phuchuynhbk24-cmd/Smart_Room_Control/docs/SYSTEM_SPECIFICATION_REPORT.docx

BÁO CÁO ĐẶC TẢ HỆ THỐNG
(SYSTEM SPECIFICATION REPORT)

DỰ ÁN: HỆ THỐNG ĐIỀU KHIỂN PHÒNG THÔNG MINH (SMART ROOM CONTROL)
PHÂN HỆ: GIAO DIỆN HMI, MÀN HÌNH TFT, CẢM ỨNG, NÚT BẤM VÀ CƠ CẤU CHẤP HÀNH RELAY
Chuẩn cấu trúc 5 giai đoạn tài liệu (Documents for System Specification)

• Phạm vi thực hiện: Phân hệ của Coder 1 (Màn hình màu TFT ILI9341, Cảm ứng điện trở XPT2046, Khối 4 nút cơ SW2..SW5, Khối 4 Rơ-le công suất, Dịch vụ HMI & Input Manager).
• Nền tảng phần cứng: Vi điều khiển STM32F103C8T6 (ARM Cortex-M3 @ 72 MHz, 64 KB Flash, 20 KB SRAM).
• Mô hình tài liệu: Tuân thủ cấu trúc 5 tầng tài liệu (Documents for System Specification):
[1. Product Requirement] -> [2. Design Specification] -> [3. Hardware Specification] -> [4. Software Specification] -> [5. Test Specification]
• Môn học: Thiết kế Hệ thống Nhúng (ESD) - Bộ môn Kỹ thuật Điện tử, Trường ĐH Bách Khoa TP.HCM.

1. PRODUCT REQUIREMENT (ĐẶC TẢ YÊU CẦU SẢN PHẨM)

1.1. Mục đích sản phẩm (Product Purpose):
Phân hệ đảm nhiệm vai trò trung tâm giao tiếp Người - Máy (HMI) và thực thi chấp hành trong hệ thống phòng thông minh. Sản phẩm cung cấp bảng điều khiển trung tâm (Dashboard) hiển thị thông số môi trường trực quan, cho phép người dùng điều khiển 4 thiết bị phụ tải qua cả hai phương thức: Màn hình cảm ứng hiện đại và Nút bấm vật lý truyền thống.

1.2. Yêu cầu chức năng (Functional Requirements):
• FR1 - Giám sát môi trường thời gian thực: Hiển thị liên tục Nhiệt độ (độ C, float), Độ ẩm (%, float), Độ sáng (%, float) và Trạng thái có người PIR (Phát hiện / Yên tĩnh, bool) nhận từ phân hệ cảm biến.
• FR2 - Điều khiển phụ tải 4 kênh: Điều khiển độc lập 4 thiết bị (Quạt làm mát, Đèn chiếu sáng 1, Đèn chiếu sáng 2, Máy hút ẩm) qua các rơ-le công suất cách ly quang.
• FR3 - Chế độ kép AUTO / MANUAL: Cho phép chuyển đổi linh hoạt giữa chế độ tự động (AUTO: tự đóng ngắt phụ tải theo ngưỡng môi trường) và chế độ thủ công (MANUAL: người dùng tự do bật/tắt thiết bị).
• FR4 - Trọng tài ưu tiên phần cứng (Hardware Priority): Khi có thao tác đồng thời giữa nút bấm cơ và màn hình cảm ứng, nút bấm vật lý luôn có quyền quyết định tối cao; màn hình cảm ứng phải bị vô hiệu hóa tạm thời.
• FR5 - Khóa an toàn chế độ tự động (AUTO Lockout): Ở chế độ AUTO, các tác động điều khiển rơ-le thủ công (từ cả nút bấm và cảm ứng) bị từ chối và hiển thị cảnh báo để tránh xung đột với thuật toán tự động.

1.3. Yêu cầu phi chức năng (Non-Functional Requirements):
• NFR1 - Thời gian đáp ứng (Response Time): Độ trễ từ khi nhấn nút cơ hoặc chạm màn hình đến khi rơ-le đổi trạng thái <= 50 ms.
• NFR2 - Hiển thị không nhấp nháy (Zero-Flicker): Tốc độ cập nhật vùng số liệu đồ họa <= 3 ms; không được xóa toàn bộ màn hình khi cập nhật thông số.
• NFR3 - Trải nghiệm thị giác (Ergonomics): Giao diện thiết kế theo phong cách Dark Mode hiện đại, màu sắc tương phản cao (Cam cho Nhiệt độ, Xanh cho Độ ẩm, Vàng cho Độ sáng, Đỏ cho Cảnh báo PIR).
• NFR4 - An toàn điện & Chống sốc (Electrical Isolation): Cách ly quang hoàn toàn giữa khối điều khiển 3.3V và tải công suất 220VAC/12VDC qua Optocoupler; tích hợp diode triệt tiêu xung ngược Back-EMF.

2. DESIGN SPECIFICATION (ĐẶC TẢ THIẾT KẾ HỆ THỐNG & PHÂN RÃ)

2.1. Phân rã kiến trúc phân hệ (Subsystem Functional Decomposition):
Phân hệ của Coder 1 được phân tách thành 5 phân hệ chức năng tương tác đồng bộ:

Phân hệ (Subsystem) | Chức năng chính | Công nghệ / IC sử dụng | Phân bổ HW / SW
Display Subsystem | Hiển thị giao diện đồ họa màu 240x320 | Module LCD 2.8" SPI, IC ILI9341 | HW: Bus SPI1 | SW: Driver ILI9341
Touch Subsystem | Đọc tọa độ chạm, định chuẩn pixel | Cảm ứng điện trở 4 dây, IC XPT2046 | HW: Bus SPI2 | SW: Lọc trung vị 7 mẫu
Physical Button Subsystem | Tiếp nhận 4 phím bấm cơ khí ưu tiên | 4x Tactile Switches, mạch lọc RC | HW: GPIO Pull-up | SW: Debounce 25ms
Actuator Output Subsystem | Kích hoạt đóng ngắt 4 rơ-le công suất | 4x SRD-05VDC, Opto PC817, 1N4148 | HW: GPIO Push-pull | SW: Driver Relay
HMI & Input Arbitration | Quản lý giao diện, giải quyết xung đột | Middleware UI Dashboard & Input Manager | SW: Tầng Middleware thuần C

2.2. Sơ đồ khối kiến trúc hệ thống (System Block Diagram):
Luồng điều khiển và luồng dữ liệu giữa các khối phần cứng và các module phần mềm:

┌────────────────────────────────────────────────────────────────────────┐
│ STM32F103C8T6 (72 MHz) │
│ │
│ [TẦNG APP] app_loop() Executive Loop (Kịch bản AUTO / MANUAL) │
│ ▲ │ │
│ │ Event ▼ Telemetry/Cmd │
│ [TẦNG MIDDLEWARE] │
│ ├── Input Manager (Trọng tài: Nút cơ > Cảm ứng TFT) │
│ └── UI Dashboard Service (Render vùng thẻ, thanh tiến trình) │
│ ▲ │ │
│ │ Status/Coords ▼ Drawing/Pulse │
│ [TẦNG DEVICE] │
│ ├── button_driver ├── xpt2046_driver ├── ili9341_driver │
│ └── relay_driver └── sensor_interface (Coder 2 data) │
└───────┬────────────────────────┬───────────────────────┬───────────────┘
│ GPIO (PA3,PB2,PA10,11) │ SPI2 (2.25 MHz) │ SPI1 (18 MHz)
▼ ▼ ▼
[4x Nút bấm cơ] [IC Touch XPT2046] [TFT LCD ILI9341]
(SW2,SW4,SW3,SW5) (Resistive 4-wire) (2.8 inch 240x320)
│ │
┌────────────────────────┘ │
▼ GPIO (PB4,PA15,PB6,PA12) ▼
[4x Relay Opto-isolated] [Bảng điều khiển HMI]
(FAN, LIGHT1, LIGHT2, DEHUM) (Giao diện Dark Mode)

3. HARDWARE SPECIFICATION (ĐẶC TẢ CHI TIẾT PHẦN CỨNG)

3.1. Đặc tả Lựa chọn Xung nhịp & Bus ngoại vi (Clock Selection & Bus Timing):
• Thạch anh hệ thống: HSE = 8.000 MHz nhân tần PLL x9 -> SYSCLK = HCLK = 72.000 MHz.
• Bus APB2 (PCLK2 = 72 MHz) cấp xung cho SPI1 (Màn hình ILI9341):
- Ràng buộc Datasheet ILI9341: Chu kỳ ghi nối tiếp tối thiểu T_SCYCW = 66 ns (f_max = 15.15 MHz).
- Lựa chọn bộ chia: SPI_BAUDRATEPRESCALER_4 -> f_SCK1 = 72 MHz / 4 = 18.000 MHz (T = 55.5 ns).
- Biện luận: Tần số 18 MHz nằm trong dải dung sai thực tế của silicon ILI9341 ở điện áp 3.3V, tối đa hóa thông lượng dữ liệu (18 Mbps) giúp cập nhật đồ họa mượt mà.
• Bus APB1 (PCLK1 = 36 MHz) cấp xung cho SPI2 (Cảm ứng XPT2046):
- Ràng buộc Datasheet XPT2046: Xung nhịp đồng hồ ADC tối đa cho phép f_DCLK_max = 2.500 MHz.
- Lựa chọn bộ chia: SPI_BAUDRATEPRESCALER_16 -> f_SCK2 = 36 MHz / 16 = 2.250 MHz <= 2.500 MHz.
- Biện luận: Đảm bảo độ chính xác chuyển đổi SAR ADC 12-bit, không làm nóng chip hay trôi giá trị đo.

3.2. Bảng phân bổ chân kết nối phần cứng vi điều khiển (Pinout Assignment):

Tên khối / Ngoại vi | Chân Module | Chân STM32 | Chế độ GPIO HAL | Thông số điện & Tần số
TFT LCD ILI9341 | SCK | PA5 | GPIO_MODE_AF_PP (High) | SPI1 Clock (18.0 MHz, 3.3V Logic)
TFT LCD ILI9341 | MOSI (SDI) | PA7 | GPIO_MODE_AF_PP (High) | SPI1 Master-Out Data (3.3V Logic)
TFT LCD ILI9341 | CS | PB0 | GPIO_MODE_OUTPUT_PP (High) | Tín hiệu chọn chip màn hình (Active-LOW)
TFT LCD ILI9341 | DC (RS) | PB1 | GPIO_MODE_OUTPUT_PP (High) | 0 = Command Byte, 1 = Data Byte
TFT LCD ILI9341 | RST | PA4 | GPIO_MODE_OUTPUT_PP (Low) | Reset phần cứng (Xung thấp >= 10 us)
TFT LCD ILI9341 | LED (BL) | +3.3V | Nối nguồn qua trở hạn dòng | Đèn nền LED Backlight (Dòng 60-80 mA)
Touch XPT2046 | T_CLK | PB13 | GPIO_MODE_AF_PP (High) | SPI2 Clock (2.25 MHz, 3.3V Logic)
Touch XPT2046 | T_DO (MISO) | PB14 | GPIO_MODE_INPUT (Floating) | SPI2 Master-In nhận dữ liệu ADC 12-bit
Touch XPT2046 | T_DIN (MOSI) | PB15 | GPIO_MODE_AF_PP (High) | SPI2 Master-Out gửi byte chọn kênh
Touch XPT2046 | T_CS | PB12 | GPIO_MODE_OUTPUT_PP (High) | Tín hiệu chọn chip cảm ứng (Active-LOW)
Touch XPT2046 | T_IRQ | PA8 | GPIO_MODE_INPUT (Pull-Up) | Ngắt báo chạm PENIRQ (Active-LOW)
Nút bấm SW2 (MODE) | PIN_SW2 | PA3 | GPIO_MODE_INPUT (Pull-Up) | Active-LOW, RC chống rung: 10k / 100nF
Nút bấm SW4 (FAN) | PIN_SW4 | PB2 | GPIO_MODE_INPUT (Pull-Up) | Active-LOW, RC chống rung: 10k / 100nF
Nút bấm SW3 (LIGHT1) | PIN_SW3 | PA10 | GPIO_MODE_INPUT (Pull-Up) | Active-LOW, RC chống rung: 10k / 100nF
Nút bấm SW5 (DEHUM) | PIN_SW5 | PA11 | GPIO_MODE_INPUT (Pull-Up) | Active-LOW, RC chống rung: 10k / 100nF
Relay 1 (FAN) | IN_RELAY1 | PB4 | GPIO_MODE_OUTPUT_PP (Low) | Kích Opto PC817 (Active-HIGH, 3.5 mA)
Relay 2 (LIGHT1) | IN_RELAY2 | PA15 | GPIO_MODE_OUTPUT_PP (Low) | Kích Opto PC817 (Active-HIGH, 3.5 mA)
Relay 3 (LIGHT2) | IN_RELAY3 | PB6 | GPIO_MODE_OUTPUT_PP (Low) | Kích Opto PC817 (Active-HIGH, 3.5 mA)
Relay 4 (DEHUM) | IN_RELAY4 | PA12 | GPIO_MODE_OUTPUT_PP (Low) | Kích Opto PC817 (Active-HIGH, 3.5 mA)

3.3. Mạch nguyên lý kết nối & Chống nhiễu phần cứng (Interface Circuits):
• Mạch lọc RC nút bấm: Cấu hình Active-LOW kéo lên 3.3V qua trở R = 10 kOhm và tụ lọc C = 100 nF mắc song song xuống GND. Hằng số thời gian phóng nạp tau = R x C = 1 ms dập tắt các xung dội cơ học ban đầu.
• Mạch cách ly rơ-le: Các chân ngõ ra kích transistor phát quang của Opto PC817 (qua trở hạn dòng 1 kOhm). Phía thứ cấp dẫn dòng kích mở transistor NPN đóng rơ-le 5V. Mắc song song ngược với cuộn hút rơ-le là Diode 1N4148 (Flyback Diode) triệt tiêu sức điện động cảm ứng Back-EMF khi ngắt dòng, bảo vệ tuyệt đối vi điều khiển.

4. SOFTWARE SPECIFICATION (ĐẶC TẢ THIẾT KẾ PHẦN MỀM & FIRMWARE)

4.1. Cấu trúc Firmware 4 tầng (4-Layer Firmware Architecture):
Hệ thống phân tách rạch ròi theo nguyên tắc Inversion of Control:
- Tầng APP (app/app.c, app/app.h): Điều phối chính, quản lý biến trạng thái (s_temp, s_humi, s_light, s_pir, s_mode), định kỳ 1000ms gọi sensor_update() để lấy dữ liệu từ Coder 2 và đánh giá luật kích rơ-le tự động.
- Tầng MIDDLEWARE:
+ input_mgr: Dịch vụ quét đầu vào, áp dụng thuật toán trọng tài ưu tiên (Phím cơ > Cảm ứng TFT).
+ ui_dashboard: Dịch vụ render giao diện đồ họa, vẽ thẻ card số liệu, thanh tiến trình phần trăm.
- Tầng DEVICE (device/): Trình điều khiển trực tiếp phần cứng (ili9341, xpt2046, button, relay, sensor stub).
- Tầng HAL & DRIVERS: Thư viện chuẩn ST HAL (HAL_SPI, HAL_GPIO, HAL_GetTick).

4.2. Đặc tả Thuật toán & Băng thông hiển thị ILI9341:
• Kích thước khung hình đầy đủ: 240 x 320 x 2 bytes = 153.600 bytes (1.228.800 bits).
• Thời gian nạp toàn màn hình ở 18 MHz: T_full = 1.228.800 / (18 x 10^6) = 68.27 ms (~14.64 FPS).
• Thuật toán Vẽ vùng quan tâm (ROI Partial Draw): Chỉ cập nhật vùng ô số liệu thay đổi (kích thước 94 x 28 pixels = 5.264 bytes). Thời gian nạp: T_ROI = 5.264 x 8 / (18 x 10^6) = 2.34 ms (> 420 Hz). Đảm bảo giao diện phản hồi tức thì, hoàn toàn không chớp nháy (Zero-Flicker).
• Kích thước Burst Buffer: 512 bytes (256 pixels). Chiếm 2.5% của 20 KB SRAM, tối ưu hóa hàng đợi FIFO phần cứng của SPI1 mà không gây nguy cơ tràn ngăn xếp (Stack Overflow).
• Chuỗi thanh ghi khởi tạo: Reset cứng -> Software Reset (0x01, chờ >= 120ms) -> Power Control (0xCB, 0xCF, 0xC0, 0xC1, 0xC5, 0xC7) -> Memory Access Control MADCTL (0x36 = 0x08, Portrait BGR) -> Pixel Format (0x3A = 0x55, RGB565 16-bit) -> Sleep Out (0x11, chờ >= 120ms) -> Display ON (0x29).

4.3. Đặc tả Thuật toán Cảm ứng XPT2046:
• Tần số lấy mẫu: 50 Hz (Chu kỳ 20 ms).
• Thuật toán Lọc trung vị 7 mẫu (Median Filter): Thực hiện 7 lần chuyển đổi ADC vi sai (lệnh 0xD0 cho trục X, 0x90 cho trục Y). Sắp xếp mảng tăng dần và lấy mẫu trung vị S[3], loại bỏ triệt để các xung gai điện áp ngẫu nhiên.
• Công thức định chuẩn điểm ảnh (Pixel Calibration):
X_pixel = ((X_raw - 200) * 240) / (3800 - 200)
Y_pixel = 320 - (((Y_raw - 200) * 320) / (3800 - 200))
• Khóa chống dội cảm ứng: Thời gian khóa trễ 180 ms giữa 2 lần chạm liên tiếp.

4.4. Đặc tả Thuật toán Trọng tài Ưu tiên Đầu vào (Input Priority Arbitration):
• Nguyên tắc: Nút bấm vật lý (Hardware Buttons) có độ ưu tiên cao nhất, vượt quyền hoàn toàn màn hình cảm ứng.
• Thực thi: Trong hàm input_mgr_poll(), nếu bất kỳ nút cơ nào đang được đè giữ (button_is_down == true) hoặc vừa có sự kiện nút cơ trong 400 ms trước, mọi tín hiệu chạm màn hình cảm ứng đều bị hủy bỏ (Action = INPUT_ACT_NONE). Màn hình xuất thông báo cảnh báo [HW PRIORITY] BTN OVERRIDE TOUCH.
• Khóa AUTO Mode (AUTO Lockout): Khi s_mode == 1, mọi lệnh điều khiển rơ-le thủ công (từ cả nút cơ và cảm ứng) bị từ chối thực hiện và hiển thị cảnh báo [AUTO-LOCK] màu vàng trên thanh Banner.

5. TEST SPECIFICATION (ĐẶC TẢ KIỂM THỬ HỆ THỐNG)

Tập hợp các ca kiểm thử (Test Cases) nhằm thẩm định và nghiệm thu toàn diện các chỉ tiêu kỹ thuật đã cam kết trong Product Requirement, Hardware Spec và Software Spec:

Mã kiểm thử (Test ID) | Mục tiêu kiểm thử | Quy trình thực hiện & Thiết bị đo | Kết quả mong đợi (Pass Criteria)
TC01 | Kiểm tra Tần số xung nhịp SPI1 và Băng thông màn hình ILI9341 | Kẹp đầu dò máy hiện sóng (Oscilloscope) vào chân PA5 (SCK) và PA7 (MOSI). Cho hệ thống chạy vòng lặp cập nhật số liệu liên tục. | Tần số đo được trên PA5 đạt chính xác 18.0 MHz +/- 0.5%. Dạng sóng vuông rõ ràng. Thời gian cập nhật ô số liệu <= 3 ms. Màn hình không nhấp nháy.
TC02 | Kiểm tra Tần số SPI2 và Độ chính xác cảm ứng XPT2046 | Kẹp que đo vào chân PB13 (SPI2_SCK). Dùng bút cảm ứng chạm lần lượt vào 4 góc màn hình (10,10), (230,10), (10,310), (230,310) và tâm (120,160). | Tần số SCK2 đo được là 2.25 MHz (không vượt 2.5 MHz). Tọa độ pixel hiển thị trên banner chẩn đoán sai lệch so với vị trí chạm thực tế <= 3 pixels.
TC03 | Kiểm tra Bộ lọc Chống rung 2 tầng của Nút bấm cơ khí | Kẹp kênh 1 Oscilloscope vào chân nút bấm (PA3) trước mạch RC, kênh 2 vào sau mạch RC. Nhấn nhả liên tục 50 lần với tốc độ nhanh. | Xung dội cơ học bị mạch RC san phẳng đáng kể. Phần mềm (Debounce 25ms) chỉ ghi nhận đúng 1 xung trigger (was_pressed) trên mỗi lần nhấn. Không bị kích đúp.
TC04 | Kiểm nghiệm Luật Trọng tài Ưu tiên (Hardware Button vs. Touch) | Dùng một ngón tay ấn giữ nút cơ SW4 (Bật Quạt), đồng thời tay kia chạm liên tục vào nút ảo trên màn hình cảm ứng để bật đèn hoặc đổi chế độ. | Màn hình cảm ứng bị vô hiệu hóa hoàn toàn, không có lệnh rơ-le nào từ cảm ứng được thực thi. Thanh Banner hiển thị dòng chữ [HW PRIORITY] BTN OVERRIDE TOUCH.
TC05 | Kiểm tra Thời gian đáp ứng Đóng/Ngắt Rơ-le và Xung ngược | Kẹp que đo kênh 1 vào chân kích GPIO (PB4), kênh 2 vào tiếp điểm ra của rơ-le. Kích hoạt đóng/ngắt liên tục. | Thời gian trễ từ khi chân PB4 lên mức 1 đến khi tiếp điểm rơ-le đóng lại <= 10 ms. Diode 1N4148 dập tắt hoàn toàn xung nhọn quá áp (Back-EMF <= 0.7V).
TC06 | Kiểm tra Khóa chế độ AUTO (AUTO Mode Lockout Enforcement) | Chuyển hệ thống sang chế độ AUTO (s_mode = 1, badge hiển thị AUTO màu xanh). Dùng nút cơ hoặc cảm ứng để cố gắng bật/tắt rơ-le. | Trạng thái 4 rơ-le hoàn toàn không thay đổi (duy trì theo ngưỡng cảm biến). Màn hình hiển thị nhãn cảnh báo [AUTO-LOCK] màu vàng trên nền đỏ đậm.
TC07 | Kiểm nghiệm Ổn định Dài hạn (Reliability & Memory Leak Test) | Cho hệ thống chạy liên tục 24 giờ trong điều kiện nhiệt độ phòng. Giả lập tín hiệu cảm biến biến động liên tục. | Hệ thống không bị treo (Watchdog/HardFault), không tràn bộ nhớ (RAM giữ nguyên 3.01 KB), không rớt khung hình hiển thị.

Trường ĐH Bách Khoa TP.HCM - Bộ môn Kỹ thuật Điện tử | System Specification Document

Smart Room Control | System Specification Report
