phuchuynhbk24-cmd/Smart_Room_Control/docs/SPEC_FIRMWARE_TFT.docx

ĐẶC TẢ KỸ THUẬT FIRMWARE
(FIRMWARE SPECIFICATION)

TRÌNH ĐIỀU KHIỂN & GIAO DIỆN MÀN HÌNH MÀU TFT LCD (ILI9341 + XPT2046)
Dự án: Hệ Thống Điều Khiển Phòng Thông Minh (Smart Room Control)

• Mục tiêu thiết kế: Xây dựng bộ thư viện điều khiển đồ họa hiệu năng cao, không giật hình (Zero-Flicker), xử lý cảm ứng chống nhiễu và trọng tài đầu vào ưu tiên phần cứng.
• Nền tảng thực thi: STM32F103C8T6 (Core ARM Cortex-M3 @ 72 MHz, 64 KB Flash, 20 KB SRAM)
• Môi trường phát triển: STM32CubeIDE / GNU Toolchain for STM32 (GCC 14.3.rel1)
• Tiêu chuẩn kiến trúc: Kiến trúc phân tầng độc lập (Decoupled Layered Architecture: App -> Middleware -> Device -> HAL)

1. KIẾN TRÚC PHÂN TẦNG FIRMWARE (DECOUPLED 4-LAYER ARCHITECTURE)

Toàn bộ mã nguồn firmware của dự án được tổ chức chặt chẽ theo 4 tầng tách biệt, bảo đảm khả năng mở rộng, dễ bảo trì và phân công công việc đa thành viên (Multi-developer collaboration):

• Tầng 1 - Application Layer (app/): Chứa logic nghiệp vụ tối cao, vòng lặp executive loop không khóa (non-blocking), kiểm tra ngưỡng môi trường để kích hoạt rơ-le tự động trong chế độ AUTO. Tầng App không được phép gọi trực tiếp các hàm HAL.
• Tầng 2 - Middleware Layer (middleware/): Bao gồm Dịch vụ Giao diện Đồ họa (ui_dashboard) xây dựng thẻ card, thanh đo tiến trình, và Dịch vụ Quản lý Đầu vào (input_mgr) thực hiện trọng tài ưu tiên giữa phím bấm vật lý và màn hình cảm ứng.
• Tầng 3 - Device Layer (device/): Các driver thiết bị ngoại vi độc lập: ili9341 (màn hình LCD), xpt2046 (bộ điều khiển cảm ứng), button (nút bấm chống rung), relay (đóng ngắt phụ tải) và sensor (giao diện kéo dữ liệu từ Coder 2).
• Tầng 4 - Drivers / HAL & Core Layer (Core/, Drivers/): Mã khởi tạo thạch anh, GPIO, bus SPI và thư viện phần cứng STM32F1xx HAL Driver.

2. CẤU HÌNH THAM SỐ NGOẠI VI STM32 HAL (PERIPHERAL CONFIGURATION)

Chi tiết các tham số nạp vào cấu trúc khởi tạo phần cứng trong mã nguồn C:

Thông số cấu hình | Bộ ngoại vi SPI1 (Màn hình ILI9341) | Bộ ngoại vi SPI2 (Cảm ứng XPT2046) | Căn cứ kỹ thuật lựa chọn
Bus nguồn cấp Clock | APB2 Bus (f_PCLK2 = 72 MHz) | APB1 Bus (f_PCLK1 = 36 MHz) | Giới hạn tối đa của bus vi điều khiển
BaudRate Prescaler | SPI_BAUDRATEPRESCALER_4 | SPI_BAUDRATEPRESCALER_16 | Bộ chia xung nhịp từ bus ngoại vi
Tần số xung nhịp SCK | 18.000 MHz (Chu kỳ 55.5 ns) | 2.250 MHz (Chu kỳ 444.4 ns) | Tiệm cận thông số ILI9341, dưới 2.5 MHz XPT2046
Chế độ SPI (SPI Mode) | Mode 0 (CPOL = 0, CPHA = 0) | Mode 0 (CPOL = 0, CPHA = 0) | Chốt dữ liệu ở sườn lên (Rising Edge)
Độ rộng khung dữ liệu | 8-bit (SPI_DATASIZE_8BIT) | 8-bit (SPI_DATASIZE_8BIT) | Phù hợp gửi lệnh và tách byte pixel RGB565
Thứ tự truyền bit | MSB First (SPI_FIRSTBIT_MSB) | MSB First (SPI_FIRSTBIT_MSB) | Quy chuẩn chip Ilitek & XPTEK
Quản lý Chip Select | Software (SPI_NSS_SOFT) | Software (SPI_NSS_SOFT) | Tự điều khiển chân CS qua GPIO Output
Chế độ hướng dữ liệu | Full-Duplex 2 Lines | Full-Duplex 2 Lines | Truyền nhận đồng thời trên đường MOSI/MISO

3. ĐẶC TẢ CHUỖI LỆNH KHỞI TẠO MÀN HÌNH ILI9341 (INIT COMMANDS & TIMING)

Chuỗi lệnh khởi tạo trong hàm ili9341_init() được lập trình chính xác theo khuyến nghị của Ilitek Application Notes nhằm thiết lập trạng thái nguồn ổn định, nạp đường cong Gamma tối ưu độ tương phản và mở cổng truyền dữ liệu màu:

Mã lệnh (HEX) | Tên thanh ghi chức năng | Dữ liệu nạp (Parameters) | Ý nghĩa kỹ thuật & Ràng buộc thời gian
0x01 | Software Reset (SWRESET) | Không tham số (Chờ >= 120 ms) | Khởi động lại toàn bộ logic nội, xóa cờ Sleep.
0xCB | Power Control A (PWCTRA) | 0x39, 0x2C, 0x00, 0x34, 0x02 | Cấu hình dòng xả Vcore và bảo vệ tụ bơm áp.
0xCF | Power Control B (PWCTRB) | 0x00, 0xC1, 0x30 | Kích hoạt mạch chống ESD xung điện áp ban đầu.
0xE8 | Driver Timing Control A | 0x85, 0x00, 0x78 | Định thì thời gian chuyển mạch cổng Gate non-overlap.
0xEA | Driver Timing Control B | 0x00, 0x00 | Định thì cân bằng tải cho các đường Source driver.
0xED | Power On Sequence Control | 0x64, 0x03, 0x12, 0x81 | Kiểm soát thứ tự nâng áp VGH/VGL chống vệt đen LCD.
0xF7 | Pump Ratio Control | 0x20 | Cài đặt tỉ lệ bơm áp nội x2 cho mạch tạo áp cao.
0xC0 | Power Control 1 (PWCTR1) | 0x23 | Thiết lập mức điện áp GVDD = 4.60 V.
0xC1 | Power Control 2 (PWCTR2) | 0x10 | Hệ số nhân điện áp cuộn lái dòng bước AVP/AVN.
0xC5 | VCOM Control 1 (VMCTR1) | 0x3E, 0x28 | VCOMH = 4.250 V, VCOML = -1.500 V cân bằng điện tích.
0xC7 | VCOM Control 2 (VMCTR2) | 0x86 | Offset VCOM triệt tiêu hoàn toàn hiện tượng rung hình (flicker).
0x36 | Memory Access Control (MADCTL) | 0x08 | Quét hướng dọc (Portrait), thứ tự lọc màu BGR.
0x3A | Pixel Format Set (COLMOD) | 0x55 | Thiết lập chuẩn màu 16-bit/pixel (RGB565, 65K màu).
0xB1 | Frame Rate Control (FRMCTR1) | 0x00, 0x18 | Tần số quét màng LCD nội bộ đạt 79 Hz (Chống nháy mắt).
0xE0 | Positive Gamma Correction | 15 Bytes thông số Gamma | Nạp đường cong Gamma dương (Tăng độ nét màu sáng).
0xE1 | Negative Gamma Correction | 15 Bytes thông số Gamma | Nạp đường cong Gamma âm (Tăng độ sâu màu tối).
0x11 | Sleep Out (SLPOUT) | Không tham số (Chờ >= 120 ms) | Mở mạch tạo dao động nội, nạp đầy điện tích màng LCD.
0x29 | Display ON (DISPON) | Không tham số | Kích hoạt xuất tín hiệu hình ảnh ra panel LCD.

4. TÍNH TOÁN BĂNG THÔNG, TỐC ĐỘ LÀM TƯƠI & BỘ ĐỆM BURST BUFFER

4.1. Băng thông truyền dữ liệu toàn khung hình (Full Frame Transfer):
- Số điểm ảnh trên màn hình: 240 x 320 = 76.800 pixels.
- Dung lượng dữ liệu 1 khung hình 16-bit màu: 76.800 x 2 bytes = 153.600 bytes = 1.228.800 bits.
- Thời gian truyền lý thuyết ở tốc độ bus SPI 18.0 MHz (18 Mbps):
T_frame = 1.228.800 bits / (18 x 10^6 bps) = 68.27 ms.
- Tốc độ quét khung hình tối đa khi xóa toàn màn hình: FPS_max = 1 / 0.06827 s = 14.64 khung hình/giây.
Nhận xét: Nếu mỗi chu kỳ cập nhật dữ liệu cảm biến đều xóa và vẽ lại toàn bộ 153.6 KB, vi điều khiển sẽ bị chiếm dụng bus SPI liên tục gần 70 ms, gây ra hiện tượng giật màn hình rõ rệt bằng mắt thường.

4.2. Chiến lược Vẽ một phần theo vùng quan tâm (ROI - Region of Interest Partial Refresh):
Firmware áp dụng phương pháp vẽ khung tĩnh một lần duy nhất lúc khởi động (UI_Init_Dashboard). Khi có dữ liệu cảm biến mới hoặc trạng thái rơ-le thay đổi:
- Chỉ mở cửa sổ địa chỉ RAM nội (Window Set: 0x2A, 0x2B, 0x2C) đúng kích thước ô số liệu (ví dụ ô nhiệt độ: 94 x 28 pixels = 2.632 pixels = 5.264 bytes).
- Thời gian truyền dữ liệu vùng số liệu:
T_ROI = (5.264 bytes x 8) / (18 x 10^6 bps) = 2.34 ms.
- Tốc độ làm tươi cục bộ: Tương đương > 420 Hz. Số liệu được cập nhật tức thì, mượt mà và triệt tiêu 100% hiện tượng chớp nháy (Zero-Flicker).

4.3. Đặc tả Bộ đệm truyền khối (Burst Buffer Specification):
Trong file device/ili9341/ili9341.c, bộ đệm truyền khối được ấn định kích thước:
#define BURST_PIXEL_CHUNK 256
static uint8_t s_burst_buffer[BURST_PIXEL_CHUNK * 2]; // 512 Bytes
Cơ sở kỹ thuật lựa chọn 512 Bytes:
• Vi điều khiển STM32F103C8T6 có tổng cộng 20 KB SRAM. Một mảng 512 bytes chỉ chiếm đúng 2.5% tổng dung lượng SRAM, đảm bảo an toàn tuyệt đối cho ngăn xếp (Stack) và các biến toàn cục khác.
• Khối 512 bytes đủ lớn để tận dụng tối đa hàng đợi phần cứng (FIFO) của bộ truyền SPI, giảm thiểu chi phí chuyển ngữ cảnh (Function Call Overhead) so với việc gửi từng pixel đơn lẻ.

5. ĐẶC TẢ GIẢI THUẬT CẢM ỨNG XPT2046 (FILTERING & CALIBRATION)

5.1. Tần số lấy mẫu và Giao thức đọc ADC:
- Tần số kiểm tra chạm cảm ứng: 50 Hz (Chu kỳ quét định kỳ 20 ms trong app_loop).
- Chân ngắt chạm phần cứng T_IRQ (PA8) được kéo lên mức 1. Khi có lực nhấn làm hai lớp màng điện trở chạm nhau, chân IRQ bị kéo xuống mức 0, kích hoạt hàm đọc tọa độ.
- Byte lệnh chọn kênh ADC gửi qua SPI2: 0xD0 (Đọc tọa độ trục X) và 0x90 (Đọc tọa độ trục Y) ở chế độ 12-bit phân giải vi sai.

5.2. Thuật toán Lọc trung vị 7 mẫu (Median Filter 7 Samples):
Do đặc tính vật lý của cảm ứng điện trở dễ bị ảnh hưởng bởi nhiễu nguồn và lực tì tay không đồng đều, driver không lấy kết quả của một mẫu đơn lẻ mà thực hiện quy trình lọc 7 mẫu liên tiếp:
1. Thực hiện 7 lần đọc ADC liên tiếp trên cùng một trục tọa độ: S = [s0, s1, s2, s3, s4, s5, s6].
2. Áp dụng thuật toán sắp xếp nổi bọt (Bubble Sort) để xếp dãy mẫu theo thứ tự tăng dần: S_sorted = sort(S).
3. Chọn mẫu nằm chính giữa S_sorted[3] làm giá trị đại diện.
Hiệu quả: Loại bỏ triệt để các xung gai điện áp đột biến (spikes) ở hai đầu biên, giá trị tọa độ trả về cực kỳ ổn định, không bị hiện tượng con trỏ nhảy nhót.

5.3. Công thức Hiệu chuẩn và Ánh xạ Tọa độ sang Điểm ảnh (Coordinate Calibration):
Dải giá trị thực nghiệm từ ADC 12-bit là [X_min, X_max] = [200, 3800] và [Y_min, Y_max] = [200, 3800]. Công thức chuyển đổi sang hệ tọa độ màn hình 240 x 320 pixels:
X_pixel = ((X_raw - 200) * 240) / (3800 - 200)
Y_pixel = 320 - (((Y_raw - 200) * 320) / (3800 - 200))
Giá trị tính toán được kẹp (clamp) chặt trong dải [0, 239] và [0, 319] để chống tràn bộ nhớ.

5.4. Thời gian trễ khóa chống dội cảm ứng (Touch Debounce):
Sau khi ghi nhận một sự kiện chạm hợp lệ (ví dụ chạm nút đổi chế độ hoặc bật quạt), biến đếm thời gian s_last_touch_tick khóa tiếp nhận chạm mới trong vòng 180 ms. Việc này ngăn chặn hiện tượng người dùng nhấn 1 lần nhưng hệ thống nhận thành 2 hoặc 3 lần nhấp chuột liên tiếp.

6. THIẾT KẾ GIAO DIỆN HMI & DỊCH VỤ TRỌNG TÀI ĐẦU VÀO (INPUT ARBITRATION)

6.1. Bảng màu giao diện chuẩn Dark Mode (Định dạng RGB565 16-bit):
Giao diện Dashboard được thiết kế theo phong cách hiện đại với nền tối nhằm tiết kiệm năng lượng và tăng độ tương phản khi nhìn ngoài trời:

Thành phần UI | Mã HEX 16-bit | Mã RGB 24-bit | Ý nghĩa thị giác & Công năng
Màu nền chính (Background) | 0x0821 | #080408 | Màu đen xám sâu, làm nổi bật các thẻ dữ liệu
Màu nền thẻ (Card BG) | 0x2124 | #212421 | Màu xám đậm định hình khối cảm biến
Thanh tiêu đề (Header Bar) | 0x18E3 | #181C18 | Thanh tiêu đề cố định trên cùng màn hình
Nhãn Nhiệt độ (Temp Color) | 0xFA40 | #F84800 | Màu cam đỏ biểu thị thông số nhiệt độ
Nhãn Độ ẩm (Humi Color) | 0x067F | #00CEF8 | Màu xanh ngọc biểu thị thông số độ ẩm
Nhãn Độ sáng (Light Color) | 0xFFE0 | #FFFF00 | Màu vàng tươi biểu thị độ sáng môi trường
Badge Có người (PIR Detected) | 0xF800 | #F80000 | Màu đỏ cảnh báo khi phát hiện chuyển động
Badge Yên tĩnh (PIR Clear) | 0x2945 | #292829 | Màu xám lục biểu thị phòng không có người
Nút trạng thái AUTO | 0x001F | #0000F8 | Màu xanh dương đậm báo hiệu chế độ tự động
Nút trạng thái MANUAL | 0x6320 | #636400 | Màu vàng nâu báo hiệu chế độ thủ công

6.2. Thuật toán Trọng tài Ưu tiên Đầu vào (Input Priority Arbitration):
Được hiện thực hóa trong hàm input_mgr_poll() tại tầng Middleware:
- Nguyên tắc tối cao: Nút bấm vật lý (Hardware Buttons) có độ ưu tiên tuyệt đối so với màn hình cảm ứng TFT.
- Quy tắc xử lý: Khi phát hiện bất kỳ nút bấm cơ nào đang được đè xuống (button_is_down == true) hoặc vừa có sự kiện nút bấm diễn ra trong vòng 400 ms gần nhất, mọi thao tác chạm trên màn hình cảm ứng đều bị vô hiệu hóa hoàn toàn (Action = INPUT_ACT_NONE). Màn hình lập tức hiển thị cảnh báo [HW PRIORITY] BTN OVERRIDE TOUCH trên thanh Banner chẩn đoán.
- Cơ chế khóa chế độ AUTO (AUTO Mode Lockout): Khi hệ thống đang ở chế độ AUTO (s_mode == 1), các lệnh điều khiển rơ-le thủ công từ cả nút bấm cơ và màn hình cảm ứng đều bị từ chối thực thi. Hệ thống giữ nguyên trạng thái đóng ngắt tự động theo cảm biến và phát thông báo [AUTO-LOCK] màu vàng cảnh báo người dùng.

7. DỰ TOÁN TÀI NGUYÊN BỘ NHỚ & TẢI CPU (MEMORY FOOTPRINT & CPU LOAD)

Kết quả đo kiểm thực tế từ bản dịch GCC 14.3 (Optimization -O0 Debug & -Os Release) trên vi điều khiển STM32F103C8T6:

Phân hệ phần mềm | Vị trí thư mục | Dung lượng RAM chiếm dụng | Dung lượng Flash chiếm dụng | Tải CPU ước tính
Driver màn hình LCD | device/ili9341/ | 576 Bytes (gồm 512B Burst Buffer) | 4.05 KB | < 3% (Khi vẽ vùng)
Driver cảm ứng điện trở | device/xpt2046/ | 32 Bytes (Mảng lọc trung vị) | 1.48 KB | < 1% (Quét 50 Hz)
Driver nút bấm chống rung | device/button/ | 48 Bytes (Trạng thái 4 nút) | 0.98 KB | < 0.5% (Quét định kỳ)
Driver điều khiển rơ-le | device/relay/ | 16 Bytes (Trạng thái logic 4 rơ-le) | 0.52 KB | < 0.1% (Khi kích hoạt)
Dịch vụ HMI & Input Manager | middleware/ | 2.34 KB (Font ASCII, chuỗi buffer) | 14.15 KB | < 4% (Format chuỗi)
TỔNG CỘNG PHÂN HỆ HMI | app/ + middleware/ + device/ | 3.01 KB (15.0% của 20 KB SRAM) | 21.18 KB (33.1% của 64 KB Flash) | < 8% CPU trung bình

Trường ĐH Bách Khoa TP.HCM - Bộ môn Kỹ thuật Điện tử | Embedded System Design Specification

Smart Room Control | Firmware Specification
