phuchuynhbk24-cmd/Smart_Room_Control/docs/SPEC_HARDWARE_TFT.docx

ĐẶC TẢ KỸ THUẬT PHẦN CỨNG
(HARDWARE SPECIFICATION)

PHÂN HỆ MÀN HÌNH MÀU TFT LCD (ILI9341 & XPT2046) VÀ NGOẠI VI GIAO TIẾP
Dự án: Hệ Thống Điều Khiển Phòng Thông Minh (Smart Room Control)

• Đối tượng thiết kế: Màn hình màu TFT 2.8" SPI (ILI9341), Cảm ứng điện trở (XPT2046), Khối phím bấm vật lý, Khối rơ-le công suất
• Vi điều khiển trung tâm: STM32F103C8T6 (ARM Cortex-M3 @ 72 MHz, 64 KB Flash, 20 KB SRAM)
• Tài liệu tham chiếu: Datasheet ILI9341 (Ilitek), Datasheet XPT2046 (XPTEK), STM32F103x8 Datasheet & Reference Manual (STMicroelectronics)
• Môn học: Thiết kế Hệ thống Nhúng (ESD) - Bộ môn Kỹ thuật Điện tử, Trường ĐH Bách Khoa TP.HCM

1. TỔNG QUAN VÀ LỰA CHỌN PHẦN CỨNG (HARDWARE OVERVIEW)

Phân hệ phần cứng hiển thị và tương tác người - máy (HMI) của dự án Smart Room Control bao gồm module màn hình TFT màu tích hợp cảm ứng điện trở 4 dây, khối 4 nút nhấn vật lý chống rung và khối 4 kênh rơ-le công suất cách ly quang. Toàn bộ các khối này được kết nối trực tiếp đến vi điều khiển STM32F103C8T6.

1.1. Module Màn hình màu LCD TFT (Model TJCTM24028-SPI):
- IC điều khiển hiển thị: ILI9341 (a-Si TFT LCD Single Chip Driver).
- Kích thước hiển thị: 2.8 inch, vùng hoạt động 43.20 x 57.60 mm.
- Độ phân giải: 240 x 320 điểm ảnh (pixels), hướng hiển thị Portrait (dọc).
- Khả năng hiển thị màu: 16-bit RGB565 (65.536 màu sắc).
- Giao thức truyền thông: 4-line Serial Peripheral Interface (SPI).

1.2. Module Điều khiển Cảm ứng Điện trở (Touch Controller):
- IC giải mã cảm ứng: XPT2046 (tương thích hoàn toàn ADS7843 / HR2046).
- Bộ chuyển đổi tương tự - số: 12-bit SAR ADC, chuyển đổi vi sai hoặc đơn cực.
- Tín hiệu báo chạm phần cứng: Chân PENIRQ (Active-LOW) phát hiện áp lực ngón tay.

1.3. Khối Nút bấm Vật lý và Khối Chấp hành Rơ-le:
- 4 nút bấm cơ khí hành trình ngắn (SW2, SW4, SW3, SW5) tích hợp mạch lọc RC chống rung phần cứng.
- 4 kênh rơ-le 5VDC (Songle SRD-05VDC-SL-C) đóng ngắt tải AC/DC qua mạch cách ly quang Optocoupler PC817 và diode triệt tiêu xung ngược 1N4148.

2. ĐẶC TẢ LỰA CHỌN XUNG NHỊP & ĐỊNH THÌ BUS (CLOCK TREE & TIMING SPECIFICATION)

2.1. Cây xung nhịp hệ thống (System Clock Distribution):
Để đạt hiệu năng xử lý đồ họa tối đa và phản hồi cảm ứng mượt mà, vi điều khiển được cấu hình hoạt động ở tần số kịch trần (Maximum Core Clock):
• Thạch anh ngoài (HSE): 8.000 MHz (Ổn định nhiệt độ cao hơn dao động nội HSI).
• Bộ nhân tần Phase-Locked Loop (PLL): Nhân tần x9 qua bộ chọn PLLMUL.
• Tần số vi xử lý (SYSCLK / HCLK): 8 MHz x 9 = 72.000 MHz.
• Bus ngoại vi APB2 (cấp xung cho SPI1 và GPIO): Bộ chia DIV1 -> PCLK2 = 72.000 MHz.
• Bus ngoại vi APB1 (cấp xung cho SPI2): Bộ chia DIV2 -> PCLK1 = 36.000 MHz (Giới hạn tối đa cho phép của bus APB1 trên dòng STM32F1 là 36 MHz).

HSE (8 MHz) -> PLL (x9) -> SYSCLK (72 MHz) -> AHB Prescaler (DIV1) -> HCLK (72 MHz)
├── APB2 Prescaler (DIV1) -> PCLK2 (72 MHz) -> SPI1 Prescaler (DIV4) -> SCK1 = 18.0 MHz (ILI9341)
└── APB1 Prescaler (DIV2) -> PCLK1 (36 MHz) -> SPI2 Prescaler (DIV16) -> SCK2 = 2.25 MHz (XPT2046)

2.2. Cơ sở tính toán & Lựa chọn Tần số SPI1 cấp cho Màn hình ILI9341:
Theo mục 19.3.4 (Display Serial Interface Timing Characteristics) trong Datasheet ILI9341:
- Chu kỳ xung nhịp ghi tối thiểu cho phép: T_SCYCW = 66 ns (ở dải điện áp VDD_I = 2.8V - 3.3V), tương đương tần số f_max = 15.15 MHz.
- Độ rộng xung clock mức cao T_SHW >= 15 ns, mức thấp T_SLW >= 15 ns.
Xét các hệ số chia của bộ ngoại vi SPI1 trên bus APB2 (PCLK2 = 72 MHz):
• Prescaler = 2 (f_SCK = 36.0 MHz, T = 27.8 ns): Vượt quá ngưỡng đặc tả danh định của IC ILI9341 hơn 2 lần. Dễ dẫn đến hiện tượng rớt byte, sai màu hoặc không khởi tạo được màn hình khi dây dẫn dài.
• Prescaler = 4 (f_SCK = 18.0 MHz, T = 55.5 ns): Nằm trong biên độ chịu đựng thực tế (silicon tolerance) của ILI9341 ở điện áp 3.3V. Đây là tần số lý tưởng nhất, tối đa hóa tốc độ nạp điểm ảnh (18 Mbps) mà vẫn duy trì độ toàn vẹn tín hiệu cực kỳ ổn định.
• Prescaler = 8 (f_SCK = 9.0 MHz, T = 111.1 ns): Hoàn toàn nằm trong đặc tả datasheet nhưng làm giảm một nửa tốc độ quét khung hình, khiến việc cập nhật thanh tiến trình đồ họa bị giật.
-> QUYẾT ĐỊNH THIẾT KẾ: Lựa chọn SPI_BAUDRATEPRESCALER_4 (f_SPI1 = 18.0 MHz), Mode 0 (CPOL = 0, CPHA = 0), FirstBit = MSB.

2.3. Cơ sở tính toán & Lựa chọn Tần số SPI2 cấp cho IC Cảm ứng XPT2046:
Theo bảng thông số động học trong Datasheet XPT2046:
- Xung nhịp đồng hồ chuyển đổi ADC danh định tối đa: f_DCLK_max = 2.500 MHz (tại VCC = 2.7V - 3.6V).
- Mỗi lần lấy mẫu 12-bit ADC đòi hỏi từ 16 đến 24 chu kỳ xung clock DCLK để nạp đầy mạng tụ chuyển đổi mẫu (SAR capacitive array).
Xét các hệ số chia của bộ ngoại vi SPI2 trên bus APB1 (PCLK1 = 36 MHz):
• Prescaler = 8 (f_SCK = 4.5 MHz): Vi phạm giới hạn tối đa 2.5 MHz của XPT2046, dẫn đến kết quả ADC bị sai lệch nghiêm trọng hoặc mất tính năng cảm ứng.
• Prescaler = 16 (f_SCK = 2.250 MHz): Thỏa mãn hoàn toàn điều kiện f_SCK <= 2.5 MHz (2.25 MHz < 2.5 MHz) và khai thác được 90% tốc độ chuyển đổi tối đa của IC.
• Prescaler = 32 (f_SCK = 1.125 MHz): An toàn nhưng kéo dài thời gian đọc khối 7 mẫu lọc trung vị.
-> QUYẾT ĐỊNH THIẾT KẾ: Lựa chọn SPI_BAUDRATEPRESCALER_16 (f_SPI2 = 2.25 MHz), Mode 0 (CPOL = 0, CPHA = 0), FirstBit = MSB.

3. BẢNG PHÂN BỔ CHÂN NGOẠI VI & CHẾ ĐỘ GPIO (PINOUT ASSIGNMENT)

Chi tiết phân bổ 18 chân tín hiệu giữa vi điều khiển STM32F103C8T6 và các khối ngoại vi HMI:

Thiết bị / Module | Chân Module | Chân STM32 | Cấu hình GPIO HAL | Tần số / Chức năng phần cứng
TFT ILI9341 | SCK | PA5 | GPIO_MODE_AF_PP (Speed: High) | SPI1_SCK (18.0 MHz) phát xung đồng hồ
TFT ILI9341 | MOSI (SDI) | PA7 | GPIO_MODE_AF_PP (Speed: High) | SPI1_MOSI đường truyền lệnh & dữ liệu màu
TFT ILI9341 | CS | PB0 | GPIO_MODE_OUTPUT_PP (Speed: High) | Tín hiệu chọn chip hiển thị (Active-LOW)
TFT ILI9341 | DC (RS) | PB1 | GPIO_MODE_OUTPUT_PP (Speed: High) | Data/Command (0: Command, 1: Data)
TFT ILI9341 | RESET | PA4 | GPIO_MODE_OUTPUT_PP (Speed: Low) | Reset cứng LCD (Kéo thấp tối thiểu 10 us)
TFT ILI9341 | LED (BL) | +3.3V | Nối nguồn qua trở hạn dòng | Đèn nền LED backlight (Dòng 60-80 mA)
TOUCH XPT2046 | T_CLK | PB13 | GPIO_MODE_AF_PP (Speed: High) | SPI2_SCK (2.25 MHz) xung nhịp ADC
TOUCH XPT2046 | T_DO (MISO) | PB14 | GPIO_MODE_INPUT (Floating) | SPI2_MISO nhận kết quả 12-bit ADC
TOUCH XPT2046 | T_DIN (MOSI) | PB15 | GPIO_MODE_AF_PP (Speed: High) | SPI2_MOSI phát lệnh chọn kênh cảm ứng
TOUCH XPT2046 | T_CS | PB12 | GPIO_MODE_OUTPUT_PP (Speed: High) | Chọn chip cảm ứng XPT2046 (Active-LOW)
TOUCH XPT2046 | T_IRQ | PA8 | GPIO_MODE_INPUT (Pull-Up) | Ngắt báo chạm phần cứng PENIRQ (Active-LOW)
Nút bấm cơ SW2 | MODE | PA3 | GPIO_MODE_INPUT (Pull-Up) | Chuyển chế độ AUTO / MANUAL (RC 10k/100nF)
Nút bấm cơ SW4 | FAN | PB2 | GPIO_MODE_INPUT (Pull-Up) | Đảo trạng thái Quạt làm mát (RC 10k/100nF)
Nút bấm cơ SW3 | LIGHT 1 | PA10 | GPIO_MODE_INPUT (Pull-Up) | Đảo trạng thái Đèn chiếu sáng 1 (RC 10k/100nF)
Nút bấm cơ SW5 | DEHUM | PA11 | GPIO_MODE_INPUT (Pull-Up) | Đảo trạng thái Máy hút ẩm (RC 10k/100nF)
Relay Kênh 1 | IN_FAN | PB4 | GPIO_MODE_OUTPUT_PP (Speed: Low) | Kích Opto cách ly Quạt (Active-HIGH)
Relay Kênh 2 | IN_LIGHT1 | PA15 | GPIO_MODE_OUTPUT_PP (Speed: Low) | Kích Opto cách ly Đèn 1 (Active-HIGH)
Relay Kênh 3 | IN_LIGHT2 | PB6 | GPIO_MODE_OUTPUT_PP (Speed: Low) | Kích Opto cách ly Đèn 2 (Active-HIGH)
Relay Kênh 4 | IN_DEHUM | PA12 | GPIO_MODE_OUTPUT_PP (Speed: Low) | Kích Opto cách ly Máy hút ẩm (Active-HIGH)

4. ĐẶC TẢ THÔNG SỐ ĐIỆN, NĂNG LƯỢNG & MÔI TRƯỜNG HOẠT ĐỘNG

Thông số kỹ thuật | Ký hiệu | Giá trị tối thiểu | Giá trị danh định | Giá trị tối đa | Đơn vị
Điện áp cấp nguồn VCC | V_CC | 3.15 | 3.30 | 5.00 (qua LDO) | V
Mức điện áp logic vào cao (High Input) | V_IH | 0.7 x VDD_I | 3.30 | VDD_I + 0.3 | V
Mức điện áp logic vào thấp (Low Input) | V_IL | -0.3 | 0.00 | 0.3 x VDD_I | V
Dòng tiêu thụ hiển thị tĩnh | I_DD_LCD | - | 9.5 | 12.0 | mA
Dòng đèn nền LED Backlight | I_LED | 50.0 | 65.0 | 80.0 | mA
Dòng tiêu thụ chip Touch XPT2046 | I_TOUCH | 0.15 | 0.26 | 0.50 | mA
Dòng kích mạch Optocoupler Relay | I_IN_RELAY | 2.0 | 3.5 | 5.0 | mA
Nhiệt độ vận hành danh định | T_OPR | -20 | +25 | +70 | °C
Nhiệt độ lưu trữ | T_STG | -30 | - | +80 | °C

5. SƠ ĐỒ MẠCH PHỐI GHÉP PHẦN CỨNG (INTERFACE CIRCUITS)

5.1. Mạch giao tiếp 4-line Serial SPI với ILI9341:
Đường truyền dữ liệu một chiều Master-Out-Slave-In (MOSI) được kết nối trực tiếp từ chân PA7 của STM32 đến chân SDI của module LCD. Đường SCK nối từ PA5. Chân DC (PB1) chuyển mạch linh hoạt giữa byte lệnh và byte dữ liệu. Chân CS (PB0) được kéo xuống mức 0 trước mỗi gói truyền và nâng lên 1 khi hoàn tất.

5.2. Mạch lọc chống rung phần cứng cho 4 Nút bấm cơ:
Mỗi nút bấm được cấu hình ngõ vào tích cực mức thấp (Active-LOW). Đường dây được kéo lên nguồn 3.3V qua điện trở R = 10 kOhm và mắc song song với tụ gốm lọc nhiễu C = 100 nF xuống GND. Hằng số thời gian phóng nạp tau = R x C = 1 ms giúp dập tắt hoàn toàn các xung gai cơ khí tần số cao phát sinh do lá đồng tiếp điểm va đập lúc nhấn.

+3.3V
│
[10k Pull-Up]
│
MCU GPIO ──────┼───────[ 100nF Filter ]────── GND
│
[Push Button SW]
│
GND

5.3. Mạch cách ly quang điều khiển Rơ-le:
Các chân GPIO (PB4, PA15, PB6, PA12) điều khiển đèn LED phát quang bên trong Optocoupler PC817 qua điện trở hạn dòng 1 kOhm. Phía thứ cấp của PC817 kích hoạt transistor NPN mở dòng qua cuộn hút rơ-le 5V. Mắc song song ngược cực với cuộn hút là Diode 1N4148 (Flyback diode) để triệt tiêu sức điện động cảm ứng (Back-EMF), bảo vệ linh kiện bán dẫn khỏi quá áp khi ngắt rơ-le.

Trường ĐH Bách Khoa TP.HCM - Bộ môn Kỹ thuật Điện tử | Embedded System Design Specification

Smart Room Control | Hardware Specification
