phuchuynhbk24-cmd/Smart_Room_Control/Core/Src/main.c

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
/* Includes ------------------------------------------------------------------*/
#include "main.h"

/* USER CODE BEGIN Includes */
#include "ili9341.h"
#include "xpt2046.h"
#include "button.h"
#include "relay.h"
#include "app.h"
/* USER CODE END Includes */

SPI_HandleTypeDef hspi1;
SPI_HandleTypeDef hspi2;

void SystemClock_Config(void);
static void MX_GPIO_Init(void);
static void MX_SPI1_Init(void);
static void MX_SPI2_Init(void);
/**
  * @brief  The application entry point.
  * @retval int
  */
int main(void)
{

  /* MCU Configuration--------------------------------------------------------*/

  /* Reset of all peripherals, Initializes the Flash interface and the Systick. */
  HAL_Init();

  /* Configure the system clock */
  SystemClock_Config();

  /* Initialize all configured peripherals */
  MX_GPIO_Init();
  MX_SPI1_Init();
  MX_SPI2_Init();
  /* USER CODE BEGIN 2 */
  /* Initialize Device Drivers */
  ili9341_init();
  xpt2046_init();
  button_init();
  relay_init();

  /* Initialize Application */
  app_init();
  /* USER CODE END 2 */

  /* Infinite loop */
  /* USER CODE BEGIN WHILE */
  while (1)
  {
    /* USER CODE END WHILE */

    /* USER CODE BEGIN 3 */
    app_loop();
  }
  /* USER CODE END 3 */
}

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
/* USER CODE BEGIN 4 */
void HAL_GPIO_EXTI_Callback(uint16_t GPIO_Pin)
{
  (void)GPIO_Pin;
}
/* USER CODE END 4 */
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
