phuchuynhbk24-cmd/Smart_Room_Control/Core/Inc/main.h

#define SYS_HEARTBEAT_Pin GPIO_PIN_13
#define SYS_HEARTBEAT_GPIO_Port GPIOC
#define LCD_CS_Pin GPIO_PIN_4
#define LCD_CS_GPIO_Port GPIOA
#define LCD_DC_Pin GPIO_PIN_0
#define LCD_DC_GPIO_Port GPIOB
#define LCD_RST_Pin GPIO_PIN_1
#define LCD_RST_GPIO_Port GPIOB
#define TOUCH_IRQ_Pin GPIO_PIN_11
#define TOUCH_IRQ_GPIO_Port GPIOB
#define TOUCH_IRQ_EXTI_IRQn EXTI15_10_IRQn
#define TOUCH_CS_Pin GPIO_PIN_12
#define TOUCH_CS_GPIO_Port GPIOB
#define RELAY_FAN_Pin GPIO_PIN_4
#define RELAY_FAN_GPIO_Port GPIOB
#define RELAY_LIGHT1_Pin GPIO_PIN_15
#define RELAY_LIGHT1_GPIO_Port GPIOA
#define RELAY_LIGHT2_Pin GPIO_PIN_6
#define RELAY_LIGHT2_GPIO_Port GPIOB
#define RELAY_DEHUM_Pin GPIO_PIN_12
#define RELAY_DEHUM_GPIO_Port GPIOA
#define BTN_1_Pin GPIO_PIN_3
#define BTN_1_GPIO_Port GPIOA
#define BTN_2_Pin GPIO_PIN_2
#define BTN_2_GPIO_Port GPIOB
#define BTN_3_Pin GPIO_PIN_10
#define BTN_3_GPIO_Port GPIOA
#define BTN_4_Pin GPIO_PIN_11
#define BTN_4_GPIO_Port GPIOA
