phuchuynhbk24-cmd/Smart_Room_Control/Core/Inc/sensor.h

/**
 * @file    sensor.h
 * @brief   Compatibility header forwarding to device/sensor/sensor.h
 */

#ifndef INC_SENSOR_H_
#define INC_SENSOR_H_

#include "../../device/sensor/sensor.h"

#endif /* INC_SENSOR_H_ */
