phuchuynhbk24-cmd/Smart_Room_Control/Core/Inc/ui_dashboard.h

/**
 * @file    ui_dashboard.h
 * @brief   Compatibility header forwarding to middleware/ui/ui_dashboard.h
 */

#ifndef UI_DASHBOARD_COMPAT_H
#define UI_DASHBOARD_COMPAT_H

#include "../../middleware/ui/ui_dashboard.h"

#endif /* UI_DASHBOARD_COMPAT_H */
