phuchuynhbk24-cmd/Smart_Room_Control/(commit log)

2026-09-27 feat: Initial commit - STM32F103C8T6 Smart Room Control with hardware pinout and report
2026-10-02 feat(hmi): complete Week 1 ILI9341 TFT display driver and testbench
    - Implement 6 core driver functions (init, write_command, write_data, draw_pixel, fill_rect, fill_screen) with 16-bit RGB565 and 512B burst transfer
    - Configure PA1 as GPIO_Output (LCD_BL) for backlight control
    - Add visual UI testbench sequence in Core/Src/main.c
    - Add technical documentation in docs/ and device/ili9341/
2026-10-03 feat: implement XPT2046 resistive touch driver and interactive HMI controls
2026-10-03 fix(touch): eliminate IRQ dropout during sampling, expand ADC boundaries, and enlarge button hitboxes
    [main.c, xpt2046.c, xpt2046.h]
2026-10-03 fix(touch & exti): implement EXTI callback, fix portrait axis mapping, partition 2x2 relay matrix, and sync hardware GPIOs
    [main.c, xpt2046.c]
2026-10-03 fix(touch): align true physical axes (SWAP_XY=0, INVERT_Y=1) and partition 2x2 relay matrix with zero dead-zone
    [main.c, xpt2046.c]
2026-10-03 feat(control): enforce strict lockout in AUTO mode with visual warning and autonomous sensor regulation
2026-10-03 fix(touch): restore live coordinates on every touch, expand mode hitbox, and boot in MANUAL mode
    [main.c]
2026-10-04 refactor(ioc): sync pinout with schematic keeping TFT and touch display only
    - Update Smart_Room_Control.ioc to keep only TFT (ILI9341 on SPI1) and Touch (XPT2046 on SPI2) peripherals and pins matching new KiCad schematic
    - Move LCD_DC to PB0 and LCD_RST to PB1
    - Remove unused relay/LED/sensor GPIOs and peripheral inits (ADC1, TIM2, USART1)
    - Add compile-time guards for backlight control as LCD_BL is hardwired to 3V3 in schematic
    - Verified build: 0 errors, 0 warnings
    [Smart_Room_Control.ioc, ili9341.c, main.c, main.h]
2026-10-04 refactor(cleanup): remove dead peripheral drivers, callbacks, and button polling
    - Disable unused HAL modules (ADC, TIM, UART) in stm32f1xx_hal_conf.h
    - Remove dead peripheral handles (hadc1, htim2, huart1) and initialization functions in main.c
    - Remove physical button EXTI polling loop in main.c (UI/touch controlled only)
    - Remove empty EXTI handlers (EXTI3, EXTI4, EXTI9_5) and unused MSP callbacks
    - Flash text size reduced from 19,712 to 18,792 bytes (-920 bytes)
    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
    [main.c, main.h]
2026-10-05 fix(hmi): disable touch toggle on motion card to make it read-only in all modes
    - Removed touch hitbox (y: 135..190) so PIR motion state cannot be manually toggled in AUTO or MANUAL mode
    - Motion remains strictly a sensor/telemetry indicator
    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
    [main.c]
2026-10-05 feat(relay): add physical GPIO actuation synchronized with TFT touch controls
    - Map relay GPIOs to new schematic: FAN (PB4), LIGHT_1 (PA15), LIGHT_2 (PB6), DEHUMIDIFIER (PA12)
    - Configure AFIO SWJ remap in MX_GPIO_Init to free PA15 and PB4 from JTAG
    - Synchronize physical relay pin states immediately when toggled on TFT touch UI
    - Default all relays to OFF (0) on startup for safe power-on state
    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
    [Smart_Room_Control.ioc, main.c, main.h]
2026-10-05 feat(button): add dedicated push button driver with 25ms debounce and schematic mapping
2026-10-05 feat(control): grant physical buttons absolute priority over TFT touch with visual override banner
2026-10-05 refactor(arch): restructure firmware into 3-layer architecture (APP -> MIDDLEWARE -> DEVICE -> HAL)
2026-10-05 fix(ide): add app and middleware to sourceEntries in .cproject and restore ui_dashboard.h compat header
    [ui_dashboard.h]
2026-10-06 feat(telemetry): update sensor interface to float light and bool PIR for multi-developer integration
2026-10-06 feat(sensor): decouple sensor device library for Coder 2 with standardized getter APIs
